IE-TDD-EL3313/Proyecto_3/docs/diseño/planteamiento.md

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

---

## 1. Introducción y comprensión del problema

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

---

## 2. Objetivos del proyecto

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

**Objetivos específicos:**

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

---

## 3. Arquitectura general y subsistemas

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

Los principales bloques funcionales considerados son:

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

**Distribución hardware / software:**

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

---

## 4. Diagrama de primer nivel

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

**Entradas:**

| Señal | Descripción |
|---|---|
| `CLK` | Reloj principal de 100 MHz. |
| `BTN_RST` | Solicitud de reinicio de la partida, procesada por software y conservando el contador de victorias. |
| `arriba`, `abajo`, `izquierda`, `derecha` | Navegación del cursor del Jugador 1. |
| `BTN_SEL` | Selección / rotación de barco. |
| `BTN_OK` | Confirmación de colocación o disparo. |
| `UART_RX` | Recepción serial desde la PC del Jugador 2. |

**Salidas:**

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

Diagrama de primer nivel del sistema

---

## 5. Diagrama de segundo nivel

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

Diagrama de segundo nivel del sistema

---

## 6. Diagramas de tercer nivel

El tercer nivel presenta los bloques funcionales internos de la solución, organizado en cuatro diagramas principales.

### 6.1 Procesador RISC-V

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

#### Señales de entrada

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

#### Señales de salida

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

#### Señales de control (generadas por la Unidad de Control)

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

#### Explicación del datapath

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

#### Memoria ROM

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

#### Bus de datos e interconexión MMIO

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

#### Decodificación de direcciones

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

Las principales señales de selección consideradas en la interconexión
son:

- `sel_RAM`
- `sel_UART`
- `sel_INPUT`
- `sel_DISPLAY`
- `sel_LED`
- `sel_BUZZER`
- `sel_VGA`

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

#### Generación de habilitaciones de escritura

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

\[
we_x = we_o \land sel_x
\]

donde `sel_x` representa la señal de selección del dispositivo
correspondiente.

Por ejemplo, para la memoria RAM y el periférico UART se tiene

\[
we_{RAM} = we_o \land sel_{RAM}
\]

\[
we_{UART} = we_o \land sel_{UART}
\]

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

#### Memoria RAM

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

\[
RAM\_addr =
\frac{DataAddress_o - BASE_{RAM}}{4}
\]

donde `BASE_RAM` corresponde a la dirección inicial de la región
reservada para la RAM.

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

#### Adaptación de direcciones de los periféricos

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

#### Multiplexor de lectura

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

De esta manera, durante una lectura se establece el siguiente recorrido
general:

`DataAddress_o` → decodificador → selección del dispositivo →
dato de lectura → multiplexor → `DataIn_i`.

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

#### Integración del periférico UART

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

### 6.4 Periféricos locales

El bloque de periféricos locales agrupa cuatro subsistemas: entradas del Jugador 1,
displays de 7 segmentos, LED de estado y buzzer. La decodificación de direcciones MMIO
se realiza externamente en el bloque de interconexión de P3. Por esta razón,
`perifericos_locales` no recibe una dirección local; cada periférico recibe directamente
su señal de escritura ya calificada y expone de forma independiente su dato de lectura
hacia el multiplexor central.

#### Señales de entrada

| Señal | Ancho | Origen | Descripción |
|---|---|---|---|
| `clk_i` | 1 bit | Externo | Reloj del sistema, 100 MHz. |
| `rst_i` | 1 bit | Externo | Reinicio de los periféricos locales. |
| `btn_raw_i[6:0]` | 7 bits | Botones físicos | Arriba, abajo, izquierda, derecha, SEL, OK y RST sin filtrar. |
| `disp_wdata_i[31:0]` | 32 bits | CPU / interconexión MMIO | Dato de escritura para el display de 7 segmentos. |
| `disp_we_i` | 1 bit | Decodificador MMIO | Habilitación de escritura del display. |
| `led_wdata_i[31:0]` | 32 bits | CPU / interconexión MMIO | Dato de escritura para el LED de estado. |
| `led_we_i` | 1 bit | Decodificador MMIO | Habilitación de escritura del LED. |
| `buzz_wdata_i[31:0]` | 32 bits | CPU / interconexión MMIO | Dato de escritura para el buzzer. |
| `buzz_we_i` | 1 bit | Decodificador MMIO | Habilitación de escritura del buzzer. |

#### Señales de salida

| Señal | Ancho | Destino | Descripción |
|---|---|---|---|
| `rdata_input_o[31:0]` | 32 bits | Multiplexor de lectura MMIO | Estado procesado de los botones del Jugador 1. |
| `rdata_display_o[31:0]` | 32 bits | Multiplexor de lectura MMIO | Valor almacenado en el registro del display. |
| `rdata_led_o[31:0]` | 32 bits | Multiplexor de lectura MMIO | Valor almacenado en el registro del LED. |
| `rdata_buzzer_o[31:0]` | 32 bits | Multiplexor de lectura MMIO | Estado y selección del buzzer. |
| `seg_o[6:0]` | 7 bits | Displays físicos | Patrón de segmentos activo en bajo. |
| `anode_o[3:0]` | 4 bits | Displays físicos | Selección de dígito activa en bajo. |
| `led_o[2:0]` | 3 bits | LED físicos | Indicador de fase del juego. |
| `buzz_pwm_o` | 1 bit | Buzzer físico | Señal de audio generada por el buzzer. |

#### Explicación del bloque
 
Las entradas físicas del Jugador 1 pasan por una cadena de sincronización, filtrado
antirrebote y detección de flanco antes de quedar disponibles en `rdata_input_o`. Los
displays de 7 segmentos almacenan cuatro dígitos BCD y los multiplexan por persistencia
de visión hacia `seg_o` y `anode_o`. El registro de LED controla directamente los tres
bits de `led_o`. El buzzer recibe un código de tono y un disparo puntual, y genera de
forma autónoma la señal de audio correspondiente.

Las direcciones MMIO (`0x0001_0120`, `0x0001_0130`, `0x0001_0138` y `0x0001_0140`)
son decodificadas fuera de este módulo. El bloque de interconexión de P3 genera las
señales `disp_we_i`, `led_we_i` y `buzz_we_i`, y selecciona posteriormente entre
`rdata_input_o`, `rdata_display_o`, `rdata_led_o` y `rdata_buzzer_o` para devolver
el dato correspondiente al CPU.

Diagrama de tercer nivel del sistema1

Diagrama de tercer nivel del sistema2

---

## 7. Diagramas de cuarto nivel

Cada módulo funcional identificado en el nivel anterior se documenta individualmente con:

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

**Formato de tabla de señales:**

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

**Módulos a documentar** (uno por cada uno, siguiendo el formato anterior):

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

### 7.1 Registros de transmisión y recepción del UART

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

#### Registro de transmisión (TX)

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

$$
load_{TX} = write\_enable_i \land (addr_i = 01)
$$

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

##### Entradas del registro TX

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

##### Salidas del registro TX

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

#### Registro de recepción (RX)

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

De forma conceptual, la operación de carga del registro puede
representarse como:

$$
RX \leftarrow rx\_data
\qquad \text{si} \qquad
rx\_load = 1
$$

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

##### Entradas del registro RX

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

##### Salidas del registro RX

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

Diagrama de cuarto nivel de los registros TX y RX del UART.

#### Relación con los demás módulos

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

Durante una transmisión, el flujo de información es:

**Procesador → `wdata_i` → Registro TX → UART TX → `uart_tx`**

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

Durante una recepción, el flujo ocurre en sentido contrario:

**`uart_rx` → UART RX → Registro RX → interfaz de lectura → Procesador**

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

#### Funcionamiento

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

#### Diseño y justificación técnica

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

#### Comportamiento durante el reset

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

$$
rst_i = 1
\quad \Rightarrow \quad
TX = 0,\qquad RX = 0
$$

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

#### Casos especiales y condiciones de borde

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

Estas condiciones pueden resumirse mediante:

$$
load_{TX}=0
\quad \Rightarrow \quad
TX_{next}=TX
$$

$$
rx\_load=0
\quad \Rightarrow \quad
RX_{next}=RX
$$

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

#### Estrategia de validación

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

### 7.2 Registro de control y estado del UART

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

#### Objetivo

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

La condición de selección del registro puede representarse como:

$$
sel_{CTRL} = (addr_i = 00)
$$

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

$$
write_{CTRL} =
write\_enable_i \land (addr_i = 00)
$$

#### Entradas

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

#### Salidas

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

Diagrama de cuarto nivel del registro de control y estado del UART.

#### Relación con los demás módulos

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

El flujo de información de estado puede representarse como:

**UART TX / UART RX → Registro de control y estado → MUX de lectura UART → Procesador**

Para las operaciones de control realizadas por software, el flujo ocurre
en sentido contrario:

**Procesador → `wdata_i` → Registro de control y estado → lógica interna del UART**

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

#### Funcionamiento

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

La selección del dato de estado durante una lectura se produce cuando:

$$
addr_i = 00
$$

Si existen campos de control modificables por software, estos solamente
pueden actualizarse cuando se cumple:

$$
write\_enable_i = 1
\qquad \text{y} \qquad
addr_i = 00
$$

por lo que:

$$
write_{CTRL} =
write\_enable_i \land (addr_i = 00)
$$

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

#### Diseño y justificación técnica

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

#### Comportamiento durante el reset

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

De forma conceptual:

$$
rst_i = 1
\quad \Rightarrow \quad
Control = Control_{inicial}
$$

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

#### Casos especiales y condiciones de borde

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

De forma equivalente:

$$
addr_i \neq 00
\quad \Rightarrow \quad
write_{CTRL}=0
$$

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

#### Estrategia de validación

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

### 7.3 Generador de baud

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

#### Objetivo

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

#### Entradas

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

#### Salidas

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

Diagrama de cuarto nivel del generador de baud.

#### Relación con los demás módulos

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

El flujo de la señal puede representarse como:

**`clk_i` → Generador de baud → `baud_tick` → UART TX / UART RX**

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

#### Funcionamiento

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

De forma conceptual, mientras no se alcance el valor terminal:

$$
contador_{next} = contador + 1
$$

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

El comportamiento puede representarse como:

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

y la actualización del contador como:

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

$$
N = \frac{f_{clk}}{f_{tick}}
$$

Para el sistema diseñado:

$$
f_{clk}=100\text{ MHz}
$$

mientras que la comunicación UART opera a:

$$
baud=115200\text{ baudios}
$$

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

#### Diseño y justificación técnica

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

#### Comportamiento durante el reset

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

Conceptualmente:

$$
rst_i=1
\quad\Rightarrow\quad
contador=0
$$

$$
rst_i=1
\quad\Rightarrow\quad
baud\_tick=0
$$

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

#### Casos especiales y condiciones de borde

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

#### Estrategia de validación

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

### 7.4 Transmisor UART

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

#### Objetivo

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

#### Entradas

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

#### Salidas

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

Diagrama de cuarto nivel del transmisor UART.

#### Relación con los demás módulos

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

El flujo principal de información puede representarse como:

**Registro TX → `tx_data` → UART TX → `uart_tx`**

Por otra parte, la temporización sigue el recorrido:

**Generador de baud → `baud_tick` → UART TX**

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

#### Funcionamiento

El transmisor se divide internamente en una sección de datos y una
sección de control.

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

#### Diseño y justificación técnica

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

#### Máquina de estados del transmisor

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

Las transiciones principales se representan conceptualmente como:

**IDLE → START**

cuando:

$$
tx\_start = 1
$$

Si no existe una solicitud de transmisión:

$$
tx\_start = 0
$$

la máquina permanece en `IDLE`.

Desde `START` se avanza a `DATA` cuando se presenta la referencia
temporal correspondiente:

$$
baud\_tick = 1
$$

Mientras no se haya alcanzado la última posición de datos, la máquina
permanece en `DATA`:

$$
baud\_tick = 1 \land \neg fin\_trama
$$

Cuando se alcanza la última posición:

$$
baud\_tick = 1 \land fin\_trama
$$

la máquina avanza hacia `STOP`.

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

Máquina de estados del transmisor UART.

#### Control interno del transmisor

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

La relación entre ambos bloques puede representarse como:

**FSM TX → `enable_cnt` → Contador**

y:

**Contador → `fin_trama` → FSM TX**

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

#### Comportamiento durante el reset

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

Conceptualmente:

$$
rst_i = 1
\quad\Rightarrow\quad
estado_{TX}=IDLE
$$

y:

$$
rst_i = 1
\quad\Rightarrow\quad
contador_{TX}=0
$$

Esto evita que una transmisión incompleta continúe después de un
reinicio del sistema.

#### Casos especiales y condiciones de borde

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

#### Estrategia de validación

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

Durante la simulación se comprobará que la máquina de estados siga la
secuencia esperada:

**IDLE → START → DATA → STOP → IDLE**

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

### 7.5 Receptor UART

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

#### Objetivo

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

#### Entradas

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

#### Salidas

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

Diagrama de cuarto nivel del receptor UART.

#### Relación con los demás módulos

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

El flujo principal de recepción puede representarse como:

**`uart_rx` → UART RX → `rx_data` → Registro RX**

El generador de baud proporciona la referencia temporal utilizada
durante este proceso:

**Generador de baud → `baud_tick` → UART RX**

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

El flujo de control correspondiente es:

**UART RX → `rx_done`, `rx_valid` → Lógica de detección/recuperación → `rx_load`**

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

#### Funcionamiento

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

#### Diseño y justificación técnica

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

#### Máquina de estados del receptor

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

$$
uart\_rx = 1
\quad\Rightarrow\quad
estado_{next}=IDLE
$$

Cuando se detecta la condición de inicio:

$$
uart\_rx = 0
\quad\Rightarrow\quad
IDLE \rightarrow START
$$

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

$$
baud\_tick = 1
\quad\Rightarrow\quad
START \rightarrow DATA
$$

Mientras no se haya alcanzado la última posición de datos, el receptor
permanece en `DATA`:

$$
baud\_tick = 1 \land \neg fin\_datos
\quad\Rightarrow\quad
DATA \rightarrow DATA
$$

Cuando se alcanza la última posición:

$$
baud\_tick = 1 \land fin\_datos
\quad\Rightarrow\quad
DATA \rightarrow STOP
$$

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

Máquina de estados del receptor UART.

#### Control interno del receptor

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

La relación entre ambos bloques puede representarse como:

**FSM RX → `enable_cnt` → Contador**

y:

**Contador → `fin_datos` → FSM RX**

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

#### Comportamiento durante el reset

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

Conceptualmente:

$$
rst_i = 1
\quad\Rightarrow\quad
estado_{RX}=IDLE
$$

$$
rst_i = 1
\quad\Rightarrow\quad
contador_{RX}=0
$$

Además, las indicaciones asociadas con una recepción completada deben
permanecer inactivas:

$$
rst_i = 1
\quad\Rightarrow\quad
rx\_done=0
$$

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

#### Casos especiales y condiciones de borde

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

Por lo tanto, la presencia de:

$$
rx\_done=1
$$

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

#### Estrategia de validación

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

**IDLE → START → DATA → STOP → IDLE**

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

### 7.6 Detección de dato recibido y descarte/recuperación

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

Esta separación evita que una recepción finalizada pero inválida
modifique el contenido disponible para el procesador.

#### Objetivo

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

Cuando la recepción finaliza correctamente, se genera `rx_load`, que
permite almacenar `rx_data` en el registro RX.

La condición utilizada es:

`rx_load = rx_done ∧ rx_valid`

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

`discard = rx_done ∧ ¬rx_valid`

De esta manera se distinguen claramente los casos de recepción válida e
inválida.

#### Entradas

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

#### Salidas

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

Diagrama de cuarto nivel de la detección de dato recibido y la lógica de descarte y recuperación.

#### Relación con los demás módulos

Este bloque se encuentra entre el receptor UART y el registro RX.

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

El flujo de datos es:

**UART RX → `rx_data` → Registro RX**

Mientras que el flujo de control es:

**UART RX → `rx_done`, `rx_valid` → Detección/recuperación → `rx_load` → Registro RX**

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

#### Funcionamiento

El funcionamiento del bloque depende de la combinación de `rx_done` y
`rx_valid`.

Cuando:

`rx_done = 0`

no existe una nueva recepción completada. Por lo tanto:

`rx_load = 0`

`discard = 0`

Si la recepción ha finalizado y el dato es válido:

`rx_done = 1`

`rx_valid = 1`

entonces:

`rx_load = 1`

`discard = 0`

En este caso, el registro RX puede almacenar el valor presente en
`rx_data`.

Por el contrario, si la recepción finaliza pero el resultado no es
válido:

`rx_done = 1`

`rx_valid = 0`

se obtiene:

`rx_load = 0`

`discard = 1`

En este caso el dato no debe cargarse en el registro RX.

La lógica puede resumirse mediante la siguiente tabla:

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

#### Detección de dato recibido

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

La expresión utilizada es:

`rx_load = rx_done ∧ rx_valid`

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

Cuando `rx_load = 1`, el registro RX realiza conceptualmente la
operación:

`RX_next = rx_data`

Si `rx_load = 0`, el contenido previamente almacenado se conserva:

`RX_next = RX`

Esto evita que una recepción incompleta o inválida sobrescriba un dato
recibido correctamente con anterioridad.

#### Descarte y recuperación

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

La expresión correspondiente es:

`discard = rx_done ∧ ¬rx_valid`

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

#### Diseño y justificación técnica

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

#### Comportamiento durante el reset

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

Conceptualmente:

`rx_done = 0  →  rx_load = 0`

y:

`rx_done = 0  →  discard = 0`

#### Casos especiales y condiciones de borde

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

Esto garantiza que solamente la combinación:

`rx_done = 1 ∧ rx_valid = 1`

produzca `rx_load = 1`.

Cuando una recepción sea inválida, el contenido anterior del registro RX
debe mantenerse sin cambios.

#### Estrategia de validación

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

Se verificará especialmente que para:

`rx_done = 1, rx_valid = 1`

se obtenga:

`rx_load = 1, discard = 0`

y que para:

`rx_done = 1, rx_valid = 0`

se obtenga:

`rx_load = 0, discard = 1`

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

**Diagrama modular:**

Diagrama de cuarto nivel — PLL

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

**Tabla de señales:**

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

**Ecuaciones:** `f_pix = f_clk / 4 = 25 MHz`.

**Comportamiento durante el reset:** con `rst_i` activo, `locked_o = 0` y `clk_pix_o` no se
considera válido.

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

---

### 7.8 Generador de temporización VGA

**Diagrama modular:**

Diagrama de cuarto nivel — Generador de temporización VGA

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

**Tabla de señales:**

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

**Ecuaciones / tablas:**
```
if (hcount==799): hcount<=0; h_max<=1   else: hcount<=hcount+1
if (h_max): if (vcount==524): vcount<=0  else: vcount<=vcount+1
hsync_o = NOT(hcount>=656 AND hcount<752)
vsync_o = NOT(vcount>=490 AND vcount<492)
video_on_o = (hcount<640) AND (vcount<480)
```

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

**Comportamiento durante el reset:** `hcount_o=0`, `vcount_o=0`, `video_on_o=1`,
`hsync_o=vsync_o=1`.

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

---

### 7.9 Memoria de video

**Diagrama modular:**

Diagrama de cuarto nivel — Memoria de video

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

**Tabla de señales:**

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

**Ecuaciones:**
```
tile_col = hcount_i[9:5]
tile_row = vcount_i[9:5]
tile_addr = tile_row*20 + tile_col

on posedge clk_i:
    if (vga_we_i AND vga_addr_i < 300):
        mem[vga_addr_i] <= vga_wdata_i

on posedge clk_pix_i:
    if (tile_addr < 300):
        tile_data_o <= mem[tile_addr]
    else:
        tile_data_o <= 0
```

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

**Casos especiales y condiciones de borde:** la memoria física contiene 300 palabras,
correspondientes a las 20×15 casillas visibles. Las escrituras con dirección mayor o igual
a 300 se ignoran y las lecturas fuera de este rango entregan cero. La lectura del puerto
de video es síncrona y presenta una latencia de un ciclo de `clk_pix_i`; por ello,
`vga_periferico` retrasa `video_on` un ciclo antes de entregarlo al generador de color,
manteniendo alineada la habilitación de video con `tile_data_o`. Una eventual colisión de
puertos sobre la misma dirección no es crítica para la visualización.

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

---

### 7.10 Generador de color y RGB

**Diagrama modular:**

Diagrama de cuarto nivel — Generador de color y RGB

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

**Tabla de señales:**

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

**Tabla de verdad (paleta a confirmar por el equipo):**

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

**Casos especiales y condiciones de borde:** `video_on_i=0` tiene prioridad absoluta sobre
cualquier color.

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

---

### 7.11 Condicionador de entradas de botones

**Diagrama modular:**

Diagrama de cuarto nivel — Condicionador de entradas de botones

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

**Tabla de señales:**

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

**Relación con los demás módulos:** módulo hoja; expone su registro al bus de periféricos.

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

**Codificación del registro `btn_status` (`0x0001_0120`):**

| Bit | Señal |
|---|---|
| `[0]` | `nav_up_pulse` |
| `[1]` | `nav_down_pulse` |
| `[2]` | `nav_left_pulse` |
| `[3]` | `nav_right_pulse` |
| `[4]` | `sel_pulse` |
| `[5]` | `ok_pulse` |
| `[6]` | `rst_pulse` |

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

---

### 7.12 Controlador de displays de 7 segmentos

**Diagrama modular:**

Diagrama de cuarto nivel — Controlador de displays de 7 segmentos

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

**Tabla de señales:**

| Señal | Ancho | Dirección | Descripción |
|---|---|---|---|
| `clk_i` | 1 bit | Entrada | Reloj del sistema, 100 MHz. |
| `rst_i` | 1 bit | Entrada | Reset del módulo. |
| `wdata_i` | 32 bits | Entrada | 4 dígitos BCD (`0x0001_0130`). |
| `we_i` | 1 bit | Entrada | Habilitación de escritura. |
| `seg_o` | 7 bits | Salida | Patrón de segmentos activo en bajo. |
| `anode_o` | 4 bits | Salida | Selección de dígito activa en bajo. |

**Relación con los demás módulos:** módulo hoja; recibe datos del CPU vía bus de periféricos.

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

**Tabla de verdad del decodificador (`seg_o[gfedcba]`, activo en bajo):**

La tarjeta Nexys 4 utiliza lógica activa en bajo tanto para los segmentos como para
la selección de los ánodos. Por tanto, un `0` lógico en `seg_o` enciende el segmento
correspondiente y un `0` lógico en `anode_o` habilita el dígito seleccionado.

| Dígito | `seg_o[gfedcba]` |
|---|---|
| 0 | `1000000` |
| 1 | `1111001` |
| 2 | `0100100` |
| 3 | `0110000` |
| 4 | `0011001` |
| 5 | `0010010` |
| 6 | `0000010` |
| 7 | `1111000` |
| 8 | `0000000` |
| 9 | `0010000` |

La selección de dígitos también es activa en bajo. Durante el multiplexado se
mantienen los ánodos no seleccionados en `1` y únicamente el ánodo correspondiente
al dígito activo se lleva a `0`.

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

---

### 7.13 Registro del LED de estado

**Diagrama modular:**

Diagrama de cuarto nivel — Registro del LED de estado

**Objetivo:** exponer hacia el LED físico el estado actual del sistema (colocación, batalla,
resultado).

**Tabla de señales:**

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

**Codificación propuesta:**

| `led_o` | Significado |
|---|---|
| `001` | Fase de colocación |
| `010` | Fase de batalla |
| `100` | Resultado final |

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

---

### 7.14 Generador del buzzer

**Diagrama modular:**

Diagrama de cuarto nivel — Generador del buzzer

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

**Tabla de señales:**

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

**Codificación propuesta del registro de control:**

| `tone_sel` | Evento |
|---|---|
| `000` | Impacto |
| `001` | Fallo |
| `010` | Barco hundido |
| `011` | Colocación inválida |
| `100` | Victoria |

**Comportamiento durante el reset:** contadores internos en 0, `buzz_pwm_o=0` (silencio).

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

---

### 7.15 Registro del PC

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

#### Objetivo

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

#### Entradas

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

#### Salidas

| Señal | Ancho | Dirección | Descripción |
|---|---:|---|---|
| `PC[31:0]` | 32 bits | Salida | Dirección de la instrucción actual. |

#### Relación con los demás módulos

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

El flujo de la señal puede representarse como:

**`NextPC` → Registro PC → `PC` → ROM / PC + 4 / Lógica de Branch**

#### Funcionamiento

En cada flanco de subida de `clk_i`, el registro captura `NextPC`:

$$
PC_{next} = NextPC
$$

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

#### Diseño y justificación técnica

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

#### Comportamiento durante el reset

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

$$
rst_i=1
\quad\Rightarrow\quad
PC=\texttt{0x0000\_0000}
$$

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

#### Casos especiales y condiciones de borde

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

#### Estrategia de validación

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

---

### 7.16 Sumador PC+4

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

#### Objetivo

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

#### Entradas

| Señal | Ancho | Dirección | Descripción |
|---|---:|---|---|
| `PC[31:0]` | 32 bits | Entrada | Dirección de la instrucción actual. |

#### Salidas

| Señal | Ancho | Dirección | Descripción |
|---|---:|---|---|
| `PCPlus4[31:0]` | 32 bits | Salida | Dirección de la instrucción secuencial siguiente. |

#### Relación con los demás módulos

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

**Registro PC → `PC` → Sumador PC+4 → `PCPlus4` → MUX Next PC / MUX Write-back**

#### Funcionamiento

El bloque suma la constante 4 al PC, ya que cada instrucción RV32I
ocupa 4 bytes:

$$
PCPlus4 = PC + 4
$$

#### Diseño y justificación técnica

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

#### Comportamiento durante el reset

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

#### Casos especiales y condiciones de borde

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

#### Estrategia de validación

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

---

### 7.17 Banco de registros

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

#### Objetivo

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

#### Entradas

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

#### Salidas

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

Diagrama de cuarto nivel del banco de registros.

#### Relación con los demás módulos

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

**Decodificador de instrucción → `rs1`/`rs2`/`rd` → Banco de registros → `RD1`/`RD2` → ALU / Branch / Memoria**

#### Funcionamiento

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

$$
RD1 =
\begin{cases}
0, & \text{si } rs1 = 0 \\
x[rs1], & \text{en otro caso}
\end{cases}
$$

$$
RD2 =
\begin{cases}
0, & \text{si } rs2 = 0 \\
x[rs2], & \text{en otro caso}
\end{cases}
$$

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

$$
WriteEnable[i] = RegWrite \cdot (rd = i), \quad i = 1,\dots,31
$$

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

#### Diseño y justificación técnica

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

#### Comportamiento durante el reset

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

#### Casos especiales y condiciones de borde

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

#### Estrategia de validación

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

---

### 7.18 ALU

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

#### Objetivo

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

#### Entradas

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

#### Salidas

| Señal | Ancho | Dirección | Descripción |
|---|---:|---|---|
| `ALU_Result[31:0]` | 32 bits | Salida | Resultado de la operación seleccionada. |

Diagrama de cuarto nivel de la ALU.

#### Relación con los demás módulos

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

**Multiplexores de operandos + Unidad de control → ALU → `ALU_Result` → Memoria de datos / MUX Write-back**

#### Funcionamiento

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

Las operaciones aritméticas se expresan como:

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

#### Diseño y justificación técnica

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

`ALU_Control` utiliza 4 bits porque solo hay diez operaciones distintas.

#### Comportamiento durante el reset

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

#### Casos especiales y condiciones de borde

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

#### Estrategia de validación

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

---

### 7.19 Generador de inmediatos

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

#### Objetivo

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

#### Entradas

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

#### Salidas

| Señal | Ancho | Dirección | Descripción |
|---|---:|---|---|
| `Imm[31:0]` | 32 bits | Salida | Inmediato extendido con signo. |

Diagrama de cuarto nivel del generador de inmediatos.

#### Relación con los demás módulos

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

**ROM → `ProgIn_i` → Generador de inmediatos → `Imm` → MUX B / Lógica de branch**

#### Funcionamiento

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

#### Diseño y justificación técnica

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

#### Comportamiento durante el reset

El bloque es combinacional y no requiere lógica de reset.

#### Casos especiales y condiciones de borde

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

#### Estrategia de validación

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

---

### 7.20 Unidad de control

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

#### Objetivo

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

#### Entradas

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

#### Salidas

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

Diagrama de cuarto nivel de la unidad de control.

#### Relación con los demás módulos

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

**Decodificador de instrucción → Unidad de control → señales de control → Datapath**

#### Funcionamiento

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

La señal `ALUSrcA` se mantiene en 0 (`RD1`) para todas las instrucciones
soportadas.

#### Diseño y justificación técnica

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

#### Comportamiento durante el reset

La unidad de control es combinacional y no requiere lógica de reset.

#### Casos especiales y condiciones de borde

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

#### Estrategia de validación

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

---

### 7.21 Comparador de bifurcaciones y lógica de branch/saltos

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

#### Objetivo

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

#### Entradas

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

#### Salidas

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

Diagrama de cuarto nivel del comparador de bifurcaciones.

Diagrama de cuarto nivel de la lógica de branch/saltos.

#### Relación con los demás módulos

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

**Banco de registros + Unidad de control → Comparador y lógica de branch → `TargetPC` / `PCsrc` → MUX Next PC**

#### Funcionamiento

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

| BranchCtrl | Instrucción | BranchTaken |
|---|---|---|
| `00` | `beq` | `EQ` |
| `01` | `bne` | `NE` |
| `10` | `blt` | `LT` |
| `11` | `bge` | `GE` |

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

Una red de compuertas AND aplica la máscara `0xFFFF_FFFE` para poner en
cero el bit 0:

$$
AlignedTarget = TargetSum \,\&\, \texttt{0xFFFFFFFE}
$$

Un segundo multiplexor, seleccionado por `JALR`, entrega `AlignedTarget`
para `jalr` y `TargetSum` en los demás casos.

**Selección de destino.** La señal `PCsrc` se obtiene con una
compuerta AND y una compuerta OR:

$$
ConditionalTaken = Branch \cdot BranchTaken
$$

$$
PCsrc = ConditionalTaken + Jump
$$

#### Diseño y justificación técnica

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

#### Comportamiento durante el reset

El bloque es combinacional y no requiere lógica de reset.

#### Casos especiales y condiciones de borde

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

#### Estrategia de validación

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

---

### 7.22 Multiplexores de operandos de la ALU

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

#### Objetivo

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

#### Entradas

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

#### Salidas

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

#### Relación con los demás módulos

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

**Banco de registros / Generador de inmediatos → MUX A / MUX B → ALU**

#### Funcionamiento

$$
ALU\_OperandA =
\begin{cases}
RD1, & \text{si } ALUSrcA = 0 \\
PC, & \text{si } ALUSrcA = 1
\end{cases}
$$

$$
ALU\_OperandB =
\begin{cases}
RD2, & \text{si } ALUSrcB = 0 \\
Imm, & \text{si } ALUSrcB = 1
\end{cases}
$$

#### Diseño y justificación técnica

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

#### Comportamiento durante el reset

Los multiplexores son combinacionales y no requieren lógica de reset.

#### Casos especiales y condiciones de borde

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

#### Estrategia de validación

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

---

### 7.23 Multiplexor de write-back

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

#### Objetivo

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

#### Entradas

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

#### Salidas

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

#### Relación con los demás módulos

`ResultSrc` proviene de la unidad de control. La salida `WriteData` se
conecta al banco de registros.

**ALU / Memoria / PC+4 → MUX Write-back → `WriteData` → Banco de registros**

#### Funcionamiento

$$
WriteData =
\begin{cases}
ALU\_Result, & ResultSrc = 00 \\
DataIn\_i, & ResultSrc = 01 \\
PCPlus4, & ResultSrc = 10
\end{cases}
$$

#### Diseño y justificación técnica

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

#### Comportamiento durante el reset

El multiplexor es combinacional y no requiere lógica de reset.

#### Casos especiales y condiciones de borde

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

#### Estrategia de validación

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

---

### 7.24 ROM

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

#### Objetivo

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

#### Entradas

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

#### Salidas

| Señal | Ancho | Dirección | Descripción |
|---|---:|---|---|
| `ProgIn_i[31:0]` | 32 bits | Salida | Instrucción almacenada en la dirección solicitada. |

#### Relación con los demás módulos

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

**Registro PC → `ProgAddress_o` → ROM → `ProgIn_i` → Decodificador de instrucción**

#### Funcionamiento

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

$$
ProgIn\_i = ROM[ProgAddress\_o[12:2]]
$$

El contenido se carga desde el archivo generado al ensamblar el
programa.

#### Diseño y justificación técnica

La lectura se describe como combinacional porque el procesador es de
ciclo único: la instrucción debe estar disponible dentro del mismo
ciclo en que el PC cambia. Con una lectura síncrona la instrucción
llegaría un ciclo tarde y el procesador ejecutaría la instrucción
anterior. El tamaño de 2048 palabras es pequeño y puede implementarse
con la memoria distribuida de la FPGA.

No se realiza un diagrama de cuarto nivel porque la ROM es un arreglo
de memoria sin lógica interna propia que descomponer.

#### Comportamiento durante el reset

El contenido de la ROM no depende de `rst_i`. Tras el reset, el PC vale
`0x0000_0000` y la ROM entrega la primera instrucción del programa.

#### Casos especiales y condiciones de borde

Las direcciones fuera del rango `0x0000_0000` a `0x0000_1FFF` no
ocurren en operación normal, y por eso no se les asigna comportamiento.
Los bits `[1:0]` de la dirección se ignoran.

#### Estrategia de validación

Se recorrerán las direcciones del programa cargado y se comparará
`ProgIn_i` contra el archivo fuente, incluyendo la primera y la última
palabra del rango.

---

### 7.25 RAM

La RAM almacena los datos del programa: los tableros de ambos jugadores,
el turno activo, los contadores de partidas y la pila. Se accede
mediante el bus de datos, compartido con los periféricos.

#### Objetivo

El objetivo de la RAM es almacenar y devolver palabras de 32 bits en
las direcciones del rango `0x0000_2000` a `0x0000_2FFF`.

#### Entradas

| Señal | Ancho | Dirección | Descripción |
|---|---:|---|---|
| `clk_i` | 1 bit | Entrada | Reloj principal del sistema. |
| `vam.addr[9:0]` | 10 bits | Entrada | Dirección local de palabra, generada por el adaptador de dirección. |
| `DataOut_o[31:0]` | 32 bits | Entrada | Dato a escribir, proveniente del procesador. |
| `we.RAM` | 1 bit | Entrada | Habilitación de escritura, proveniente del decodificador de direcciones. |

#### Salidas

| Señal | Ancho | Dirección | Descripción |
|---|---:|---|---|
| `vam.rdata[31:0]` | 32 bits | Salida | Dato leído de la dirección local. |

#### Relación con los demás módulos

El adaptador de dirección RAM convierte `DataAddress_o` en `vam.addr`,
el decodificador de direcciones genera `we.RAM` y la salida
`vam.rdata` se dirige al multiplexor de lectura. Se representa con el
mismo bloque que aparece en el diagrama de tercer nivel del sistema.

**Procesador → Adaptador de dirección → RAM → `vam.rdata` → MUX de lectura → `DataIn_i`**

#### Funcionamiento

La RAM contiene 1024 palabras de 32 bits (4 KiB). El adaptador de
dirección elimina la base `0x0000_2000` y los dos bits de byte,
quedando:

$$
vam.addr = DataAddress\_o[11:2]
$$

La escritura es síncrona: en el flanco de subida de `clk_i`, si
`we.RAM = 1`, se almacena `DataOut_o` en la posición `vam.addr`. La
lectura es combinacional:

$$
vam.rdata = RAM[vam.addr]
$$

#### Diseño y justificación técnica

Se utiliza lectura combinacional y escritura síncrona porque en un
procesador de ciclo único el dato de un `lw` debe estar disponible
dentro del mismo ciclo para escribirse en el banco de registros. El
adaptador de dirección permite que la RAM no dependa de su posición en
el mapa de memoria global.

No se realiza un diagrama de cuarto nivel porque la RAM es un arreglo
de memoria sin lógica interna propia que descomponer.

#### Comportamiento durante el reset

El contenido de la RAM no se reinicia con `rst_i`. El enunciado
establece que la limpieza de los tableros y de los contadores se
realiza por software en la etapa de inicialización del programa.

#### Casos especiales y condiciones de borde

Solo se escribe en la RAM cuando el decodificador de direcciones activa
`we.RAM`, es decir, cuando la dirección está dentro de su rango. Los
accesos en los extremos del rango (`0x0000_2000` y `0x0000_2FFC`) deben
funcionar correctamente.

#### Estrategia de validación

Se escribirán y leerán patrones de datos distintos en varias
direcciones, incluyendo la primera y la última palabra, y se
comprobará que una escritura con `we.RAM = 0` no modifica el contenido.

---

### 7.26 Decodificador de direcciones

El decodificador de direcciones determina, a partir de
`DataAddress_o`, qué memoria o periférico participa en el acceso de
datos actual. Incluye el generador de habilitaciones de escritura, que
combina cada selección con la señal `we_o` del procesador.

#### Objetivo

El objetivo del decodificador es activar una única línea de selección
por acceso y generar la habilitación de escritura correspondiente a la
RAM y a cada periférico.

#### Entradas

| Señal | Ancho | Dirección | Descripción |
|---|---:|---|---|
| `DataAddress_o[31:0]` | 32 bits | Entrada | Dirección del acceso a datos. |
| `we_o` | 1 bit | Entrada | Escritura solicitada por el procesador. |

#### Salidas

| Señal | Ancho | Dirección | Descripción |
|---|---:|---|---|
| `sel_RAM` | 1 bit | Salida | Selecciona la RAM de datos. |
| `sel_UART` | 1 bit | Salida | Selecciona el periférico UART. |
| `sel_INPUT` | 1 bit | Salida | Selecciona las entradas del Jugador 1. |
| `sel_DISPLAY` | 1 bit | Salida | Selecciona los displays de 7 segmentos. |
| `sel_LED` | 1 bit | Salida | Selecciona el LED de estado. |
| `sel_Buzzer` | 1 bit | Salida | Selecciona el buzzer. |
| `sel_VGA` | 1 bit | Salida | Selecciona la memoria de video. |
| `we.RAM`, `we.UART`, `we.DISPLAY`, `we.LED`, `we.Buzzer`, `we.VGA` | 1 bit c/u | Salida | Habilitación de escritura de cada destino. |

Diagrama de cuarto nivel del decodificador de direcciones.

#### Relación con los demás módulos

Recibe `DataAddress_o` y `we_o` del procesador. Las señales `sel_*`
controlan el multiplexor de lectura y las señales `we.*` se conectan a
la RAM y a cada periférico.

**Procesador → Decodificador de direcciones → `sel_*` / `we.*` → RAM / Periféricos / MUX de lectura**

#### Funcionamiento

Cada selección se obtiene comparando la dirección con el rango del
mapa de memoria definido en el enunciado:

| Señal | Rango de direcciones |
|---|---|
| `sel_RAM` | `0x0000_2000` a `0x0000_2FFF` |
| `sel_UART` | `0x0001_0040` a `0x0001_0048` |
| `sel_INPUT` | `0x0001_0120` |
| `sel_DISPLAY` | `0x0001_0130` |
| `sel_LED` | `0x0001_0138` |
| `sel_Buzzer` | `0x0001_0140` |
| `sel_VGA` | `0x0001_1000` a `0x0001_17FF` |

Cada habilitación de escritura se obtiene como:

$$
we.X = we\_o \cdot sel\_X
$$

Las entradas del Jugador 1 son de solo lectura, por lo que no tienen
señal de escritura.

#### Diseño y justificación técnica

Se decodifica por rangos para cubrir de forma simple los destinos que
ocupan varias direcciones: los tres registros del UART y la memoria de
video, que abarca 512 palabras. Los rangos son disjuntos, así que a lo
sumo una selección está activa por acceso.

#### Comportamiento durante el reset

El decodificador es combinacional y no requiere lógica de reset.

#### Casos especiales y condiciones de borde

Una dirección fuera de todos los rangos no activa ninguna selección ni
ninguna habilitación de escritura, de modo que una escritura a una
dirección inválida no afecta ningún destino. Las direcciones del UART
dentro del rango pero no asignadas a un registro deben tratarse según
la definición del periférico.

#### Estrategia de validación

Se recorrerán direcciones dentro y fuera de cada rango, incluyendo el
primer y el último valor de cada uno, verificando que como máximo una
línea `sel_*` esté activa y que cada `we.*` solo se active cuando
`we_o = 1` y la dirección corresponda a su destino.

---

### 7.27 Multiplexor de lectura

El multiplexor de lectura selecciona cuál de las fuentes de datos
(RAM o periféricos) responde a una lectura del procesador.

#### Objetivo

El objetivo del multiplexor es entregar `DataIn_i` con el dato de la
memoria o del periférico seleccionado por el decodificador de
direcciones.

#### Entradas

| Señal | Ancho | Dirección | Descripción |
|---|---:|---|---|
| `vam.rdata[31:0]` | 32 bits | Entrada | Dato leído de la RAM. |
| `rdata_UART[31:0]` | 32 bits | Entrada | Dato leído del UART. |
| `rdata_INPUT[31:0]` | 32 bits | Entrada | Dato leído de las entradas del Jugador 1. |
| `rdata_DISPLAY[31:0]` | 32 bits | Entrada | Dato leído de los displays. |
| `rdata_LED[31:0]` | 32 bits | Entrada | Dato leído del LED de estado. |
| `rdata_Buzzer[31:0]` | 32 bits | Entrada | Dato leído del buzzer. |
| `rdata_VGA[31:0]` | 32 bits | Entrada | Dato leído de la memoria de video. |
| `sel_*` | 1 bit c/u | Entrada | Señales de selección del decodificador de direcciones. |

#### Salidas

| Señal | Ancho | Dirección | Descripción |
|---|---:|---|---|
| `DataIn_i[31:0]` | 32 bits | Salida | Dato entregado al procesador. |

#### Relación con los demás módulos

Recibe las salidas de lectura de la RAM y de los periféricos, y las
selecciones del decodificador de direcciones. Su salida se conecta al
puerto `DataIn_i` del procesador.

**RAM / Periféricos → MUX de lectura → `DataIn_i` → Procesador**

#### Funcionamiento

La salida corresponde a la fuente cuya señal de selección está activa:

$$
DataIn\_i =
\begin{cases}
vam.rdata, & sel\_RAM = 1 \\
rdata\_UART, & sel\_UART = 1 \\
\vdots & \vdots \\
rdata\_VGA, & sel\_VGA = 1 \\
0, & \text{en otro caso}
\end{cases}
$$

#### Diseño y justificación técnica

Se utiliza un multiplexor central en lugar de un bus compartido con
lógica de tres estados, porque los buses tri-estado internos no son la
práctica recomendada en una FPGA y el multiplexor es más sencillo de
sintetizar y verificar. Como el decodificador activa a lo sumo una
selección, no hay ambigüedad.

#### Comportamiento durante el reset

El multiplexor es combinacional y no requiere lógica de reset.

#### Casos especiales y condiciones de borde

Si ninguna selección está activa, la salida se fuerza a cero. Esto evita
inferir latches y entrega un valor definido ante una lectura de
dirección inválida.

#### Estrategia de validación

Se validará junto con el decodificador de direcciones: para cada
dirección de prueba se comprobará que `DataIn_i` corresponda a la
fuente esperada y que valga cero para direcciones fuera de rango.

## 8. Mapa de memoria, registros y organización de datos

### 8.1 Mapa de memoria

| Rango de direcciones | Componente |
|---|---|
| `0x0000_0000 – 0x0000_1FFF` | ROM de programa |
| `0x0000_2000 – 0x0000_2FFF` | RAM de datos |
| `0x0001_0000 – 0x0001_FFFF` | Periféricos mapeados en memoria |
| `0x0001_1000 – 0x0001_17FF` | Memoria de video VGA |

### 8.2 Registros de periféricos

| Periférico | Registro | Dirección |
|---|---|---|
| UART | Control/Estado | `0x0001_0040` |
| UART | Datos TX | `0x0001_0044` |
| UART | Datos RX | `0x0001_0048` |
| Entradas J1 | Estado | `0x0001_0120` |
| Displays 7-seg | Datos | `0x0001_0130` |
| LED de estado | Datos | `0x0001_0138` |
| Buzzer | Control | `0x0001_0140` |

### 8.3 Organización lógica de la RAM

La memoria RAM del sistema se encuentra ubicada en el intervalo de
direcciones comprendido entre `0x0000_2000` y `0x0000_2FFF`. Esta memoria
es utilizada por el procesador para almacenar información modificable
durante la ejecución del programa.

A diferencia de la ROM, cuyo contenido corresponde al programa ejecutado
por el procesador, la RAM almacena los datos necesarios para mantener el
estado actual de la aplicación.

#### Organización propuesta

Para facilitar el acceso desde el programa en ensamblador, se propone
dividir lógicamente la RAM en diferentes regiones de acuerdo con la
función de los datos almacenados.

La organización general propuesta es:

| Región | Contenido |
|---|---|
| Tablero local | Estado de las posiciones correspondientes al tablero del jugador local. |
| Tablero remoto | Información conocida sobre el tablero del jugador remoto. |
| Información de barcos | Datos necesarios para representar la posición y estado de los barcos. |
| Estado de la partida | Variables utilizadas para representar la etapa actual del juego. |
| Control de turnos | Información utilizada para determinar el jugador que posee el turno. |
| Resultados de disparos | Información temporal asociada con las acciones realizadas durante la partida. |
| Variables auxiliares | Contadores, índices y datos temporales utilizados por el programa. |

Esta separación es lógica y permite que el software mantenga organizada
la información utilizada durante la ejecución.

#### Direccionamiento

El procesador accede a la RAM mediante `DataAddress_o[31:0]`. Debido a
que la RAM comienza en la dirección `0x0000_2000`, la dirección interna
puede obtenerse conceptualmente eliminando el desplazamiento
correspondiente a la dirección base.

Para accesos organizados por palabras de 32 bits, la adaptación puede
representarse como:

`ram_addr = (DataAddress_o - 0x0000_2000) / 4`

De esta manera:

`0x0000_2000 → palabra 0`

`0x0000_2004 → palabra 1`

`0x0000_2008 → palabra 2`

y así sucesivamente dentro del espacio asignado a la RAM.

#### Acceso desde el procesador

Cuando `DataAddress_o` se encuentra dentro del intervalo asignado a la
RAM, el decodificador de direcciones activa `sel_RAM`.

La selección puede representarse conceptualmente como:

`sel_RAM = 1`, si `0x0000_2000 ≤ DataAddress_o ≤ 0x0000_2FFF`

Para una operación de escritura, la habilitación de la memoria se
obtiene mediante:

`we_RAM = we_o ∧ sel_RAM`

Cuando `we_RAM = 1`, el valor presente en `DataOut_o[31:0]` puede ser
almacenado en la posición seleccionada de la RAM.

Durante una lectura, el dato obtenido de la memoria se entrega mediante
`ram_rdata[31:0]` al multiplexor general de lectura:

**RAM → `ram_rdata` → MUX de lectura → `DataIn_i` → CPU**

#### Uso durante la ejecución del juego

Al comenzar la ejecución del programa, las estructuras necesarias para
representar el estado de la partida deben inicializarse antes de iniciar
el intercambio de información entre los jugadores.

Durante la fase de colocación, la RAM permite almacenar la información
que representa la configuración utilizada por el juego. Posteriormente,
durante el desarrollo de la partida, el procesador puede actualizar las
posiciones afectadas por las acciones realizadas y conservar la
información necesaria para controlar los turnos y el progreso del juego.

La utilización de regiones lógicas independientes facilita que las
rutinas en ensamblador accedan a cada estructura mediante direcciones
base y desplazamientos conocidos.

#### Justificación de la organización

La división lógica de la memoria permite separar la información según su
función y simplifica el desarrollo del programa en ensamblador.

Además, utilizar posiciones conocidas dentro de la RAM permite acceder a
las diferentes estructuras mediante operaciones convencionales de carga
y almacenamiento del procesador, sin requerir hardware adicional para
distinguir cada variable del juego.

Esta organización también facilita la depuración, ya que durante las
pruebas es posible inspeccionar regiones específicas de la memoria y
comprobar de forma independiente el contenido asociado con cada parte
del estado de la partida.

#### Condiciones de borde

Los accesos destinados a la RAM deben permanecer dentro del intervalo:

`0x0000_2000 – 0x0000_2FFF`

Una dirección fuera de este intervalo no debe activar `sel_RAM`.

Asimismo, al utilizar accesos por palabras de 32 bits, las estructuras
de software deben respetar la organización y alineamiento definidos para
evitar que dos variables utilicen accidentalmente la misma posición de
memoria.

#### Estrategia de validación

La organización de la RAM se verificará inicialmente mediante
simulación, realizando operaciones de escritura y lectura sobre
diferentes posiciones dentro del intervalo asignado.

Se comprobará que una escritura con `we_RAM = 1` modifique únicamente la
posición seleccionada y que una lectura posterior permita recuperar el
mismo valor mediante `ram_rdata`.

También se probarán las direcciones inicial y final del espacio asignado
a la RAM, así como direcciones externas al intervalo, verificando que el
decodificador active `sel_RAM` únicamente cuando corresponda.

Durante la integración con el programa en ensamblador se comprobará que
las diferentes estructuras lógicas puedan actualizarse sin interferir
entre sí.

### 8.4 Interfaz de periféricos

Los periféricos se integran al espacio MMIO mediante el decodificador de direcciones
central. Este bloque identifica la dirección solicitada por el CPU y genera una señal
de selección o escritura específica para el periférico correspondiente. De esta forma,
los periféricos que ocupan una única palabra no requieren recibir ni decodificar
localmente la dirección completa.

Las transferencias de datos se realizan mediante palabras de 32 bits. Cada periférico
expone su dato de lectura hacia el multiplexor central, que selecciona la respuesta
correspondiente según la dirección solicitada por el CPU. El VGA constituye un caso
particular, ya que su memoria de video ocupa un rango de direcciones y utiliza un índice
de 9 bits para seleccionar las posiciones de su ventana MMIO.

---

## 9. Protocolo UART, flujo del programa y aplicación de PC
### 9.1 Protocolo de aplicación sobre UART

La comunicación entre la FPGA y la aplicación ejecutada en la
computadora del Jugador 2 se realiza mediante el periférico UART a una
velocidad de 115200 baudios. En este proyecto, UART constituye el único
medio de interacción del Jugador 2 con la partida.

El protocolo de aplicación permite transmitir las órdenes del Jugador 2
hacia la FPGA y enviar desde la FPGA la información necesaria para que
la aplicación mantenga actualizada la representación de la partida.

#### Formato general de las tramas

Se propone utilizar un protocolo basado en caracteres ASCII. Cada
mensaje está compuesto por un identificador seguido por los campos
necesarios para representar la información correspondiente.

Los campos se separan mediante comas y cada trama termina con el
carácter de salto de línea `\n`.

El formato general es:

`TIPO,CAMPO1,CAMPO2,...\n`

Esta estructura permite identificar fácilmente el comienzo lógico del
mensaje mediante su tipo y detectar su final mediante `\n`.

La utilización de caracteres ASCII facilita tanto la implementación de
la aplicación Python como la depuración de la comunicación mediante una
terminal serial.

#### Mensajes desde la PC hacia la FPGA

La aplicación del Jugador 2 debe poder enviar como mínimo dos tipos de
órdenes: colocación de barcos y disparos.

##### Colocación de barco

Se define el mensaje:

`P,barco,fila,columna,orientacion\n`

donde:

| Campo | Descripción |
|---|---|
| `P` | Identifica una solicitud de colocación de barco. |
| `barco` | Identificador del barco, con valores entre 0 y 2. |
| `fila` | Fila de la casilla inicial. |
| `columna` | Columna de la casilla inicial. |
| `orientacion` | Orientación del barco: `H` para horizontal o `V` para vertical. |

Por ejemplo:

`P,1,3,4,H\n`

indica una solicitud para colocar el barco identificado como `1`,
iniciando en la fila `3`, columna `4`, con orientación horizontal.

La FPGA debe comprobar que la colocación sea válida antes de modificar
el estado de la partida.

##### Disparo

Para solicitar un disparo se define el mensaje:

`S,fila,columna\n`

donde:

| Campo | Descripción |
|---|---|
| `S` | Identifica una solicitud de disparo. |
| `fila` | Fila de la casilla objetivo. |
| `columna` | Columna de la casilla objetivo. |

Por ejemplo:

`S,5,2\n`

representa un disparo del Jugador 2 dirigido a la casilla ubicada en la
fila `5` y columna `2` del tablero del Jugador 1.

#### Mensajes desde la FPGA hacia la PC

La FPGA debe informar a la aplicación del Jugador 2 sobre los eventos
que modifican o afectan el estado de la partida.

Se proponen los siguientes tipos de mensajes.

##### Resultado de colocación

Cuando la FPGA procesa una solicitud de colocación, responde indicando
si fue aceptada o rechazada.

Colocación aceptada:

`PA,barco\n`

Por ejemplo:

`PA,1\n`

indica que la colocación del barco `1` fue aceptada.

Si la colocación es rechazada:

`PR,barco,motivo\n`

Los motivos requeridos para el rechazo son:

| Código | Motivo |
|---|---|
| `O` | El barco se traslapa con otro barco previamente colocado. |
| `F` | La posición solicitada provoca que el barco quede fuera del tablero. |

Por ejemplo:

`PR,1,O\n`

indica que la colocación del barco `1` fue rechazada debido a un
traslape.

#### Inicio de la fase de batalla

Cuando ambos jugadores hayan completado la colocación de su flota, la
FPGA informa a la aplicación que inicia la fase de batalla.

Se utiliza:

`B\n`

donde `B` representa el inicio de la batalla.

#### Cambio de turno

Para informar a quién corresponde realizar la siguiente acción se
utiliza:

`T,jugador\n`

donde `jugador` identifica al jugador que posee el turno.

Por ejemplo:

`T,2\n`

indica que corresponde actuar al Jugador 2.

#### Resultado de un disparo del Jugador 2

Después de procesar un disparo enviado por la PC, la FPGA devuelve su
resultado mediante:

`SR,fila,columna,resultado\n`

Se proponen los siguientes códigos para `resultado`:

| Código | Resultado |
|---|---|
| `F` | Fallo. |
| `I` | Impacto. |
| `H` | Barco hundido. |

Por ejemplo:

`SR,5,2,I\n`

indica que el disparo realizado sobre la fila `5`, columna `2`, produjo
un impacto.

#### Disparo recibido del Jugador 1

Cuando el Jugador 1 realiza un disparo sobre el tablero del Jugador 2,
la FPGA debe informar a la aplicación para que esta pueda actualizar la
representación del tablero propio.

Se utiliza:

`DR,fila,columna,resultado\n`

donde `resultado` utiliza los mismos códigos definidos anteriormente.

Por ejemplo:

`DR,3,6,F\n`

indica que el Jugador 1 realizó un disparo sobre la fila `3`, columna
`6`, del tablero del Jugador 2 y el resultado fue un fallo.

#### Resultado final de la partida

Cuando la partida termina, la FPGA envía:

`FIN,ganador\n`

donde `ganador` identifica al jugador que obtuvo la victoria.

Por ejemplo:

`FIN,2\n`

indica que el Jugador 2 ganó la partida.

El mensaje final puede ampliarse posteriormente con los campos
necesarios para incluir el resumen de la partida requerido por el
sistema.

#### Resumen de mensajes

| Dirección | Trama | Función |
|---|---|---|
| PC → FPGA | `P,barco,fila,columna,orientacion\n` | Solicitud de colocación de un barco. |
| PC → FPGA | `S,fila,columna\n` | Solicitud de disparo. |
| FPGA → PC | `PA,barco\n` | Colocación aceptada. |
| FPGA → PC | `PR,barco,motivo\n` | Colocación rechazada. |
| FPGA → PC | `B\n` | Inicio de la fase de batalla. |
| FPGA → PC | `T,jugador\n` | Cambio de turno. |
| FPGA → PC | `SR,fila,columna,resultado\n` | Resultado de un disparo del Jugador 2. |
| FPGA → PC | `DR,fila,columna,resultado\n` | Disparo recibido desde el Jugador 1. |
| FPGA → PC | `FIN,ganador\n` | Resultado final de la partida. |

#### Validación de mensajes

La aplicación Python debe validar la información introducida por el
Jugador 2 antes de transmitirla. Esto permite evitar el envío de
comandos evidentemente incorrectos.

Sin embargo, la FPGA también debe validar todos los mensajes recibidos y
no puede depender únicamente de la validación realizada por la
aplicación.

Un mensaje recibido debe comprobarse antes de modificar el estado de la
partida. Entre las condiciones que deben verificarse se encuentran:

- que el tipo de mensaje sea reconocido;
- que exista la cantidad esperada de campos;
- que los campos posean valores válidos;
- que el identificador del barco se encuentre entre 0 y 2;
- que la fila y columna correspondan a posiciones válidas del tablero;
- que la orientación sea `H` o `V`;
- que la acción corresponda con la fase actual de la partida;
- que el jugador pueda realizar la acción en el turno correspondiente.

#### Manejo de datos inválidos

Cualquier mensaje que no cumpla con el formato establecido debe ser
descartado sin modificar el estado actual de la partida.

Conceptualmente:

`mensaje válido → procesar comando`

`mensaje inválido → descartar y conservar estado`

De esta forma, un dato incorrecto recibido mediante UART no debe
provocar la colocación de un barco, modificar un tablero, cambiar un
turno ni generar un disparo.

Después de descartar un mensaje inválido, el sistema debe continuar
esperando una nueva trama, permitiendo recuperar la comunicación sin
necesidad de reiniciar la partida.

#### Ejemplo de comunicación

Un posible intercambio durante la colocación del Jugador 2 es:

PC → FPGA:

`P,0,2,3,H\n`

FPGA → PC:

`PA,0\n`

Posteriormente, si se intenta colocar otro barco en una posición que
produce traslape:

PC → FPGA:

`P,1,2,4,V\n`

la FPGA puede responder:

`PR,1,O\n`

Durante la fase de batalla, la FPGA informa el turno:

FPGA → PC:

`T,2\n`

El Jugador 2 realiza entonces un disparo:

PC → FPGA:

`S,5,2\n`

y la FPGA devuelve, por ejemplo:

`SR,5,2,I\n`

indicando que el disparo produjo un impacto.

Este intercambio permite que la aplicación de PC mantenga actualizada
la información presentada al Jugador 2 mientras la FPGA conserva el
control del estado general de la partida.

### 9.2 Flujo del programa ensamblador
Inicialización → colocación concurrente (J1 por VGA/botones, J2 por UART) → fase de batalla (turnos, disparos, actualización) → fin de partida → reinicio (`BTN_RST`) conservando el contador de partidas ganadas.

*(Redactar: propuesta de subrutinas y convención de registros)*

### 9.3 Aplicación de PC en Python
*(Redactar: arquitectura de la aplicación, uso de pyserial, visualización de tablero propio y estado conocido del rival, validación de entradas del usuario)*

---

## 10. Decisiones de diseño y justificación

- **Arquitectura del núcleo:** *(justificar ciclo único vs. multiciclo, tipo de unidad de control)*
- **Organización de memoria:** *(justificar bus dedicado de ROM vs. bus compartido de RAM/periféricos)*
- **Diseño VGA:** se eligió una cuadrícula de 20×15 bloques de 32×32 píxeles porque 32 es
  potencia de 2, lo que permite calcular fila/columna de tile tomando directamente los bits
  superiores de `hcount`/`vcount` (desplazamiento) en vez de un divisor aritmético completo, y
  porque esa cuadrícula alcanza para representar ambos tableros 8×8 más el HUD. La
  sincronización entre el dominio de 100 MHz (escritura del CPU) y el de 25 MHz (lectura de
  video) se resuelve mediante una memoria de tiles de doble puerto y doble reloj, primitiva
  nativa de la FPGA, sin necesidad de lógica de sincronización adicional diseñada por el
  equipo.
- **Diseño UART:** *(justificar reutilización del Proyecto 2 y ajustes necesarios)*
- **Organización de tableros:** *(justificar estructura de datos elegida)*
- **Protocolo de comunicación:** *(justificar formato de trama elegido)*

---

## 11. Estrategia de validación y plan de implementación

### 11.1 Validación por bloque

| Bloque | Prueba | Resultado esperado |
|---|---|---|
| Núcleo RISC-V | Testbench autoverificable por instrucción | Registros/memoria coinciden con el valor esperado |
| ROM / RAM | Lectura/escritura en direcciones de borde | Sin corrupción de datos |
| UART | Loopback TX→RX | Trama recibida coincide con la transmitida a 115200 baudios |
| Entradas J1 | Rebotes simulados | Antirrebote entrega un único flanco limpio |
| VGA | Inspección de temporización | `VGA_HS`/`VGA_VS` cumplen 640×480@60Hz |

### 11.2 Plan de implementación
*(Redactar: orden progresivo, p. ej. generadores de habilitación → memorias → UART → núcleo con testbench propio → VGA → entradas → integración → ensamblador del juego → aplicación Python → simulación integral → pruebas en placa)*

### 11.3 Riesgos y mitigaciones

| Riesgo | Mitigación |
|---|---|
| | |

---

## 12. Distribución del trabajo

| Persona | Área principal |
|---|---|
| P1 | Procesador RISC-V: datapath, unidad de control, banco de registros, ALU, interfaz del procesador |
| P2 | VGA y periféricos locales: controlador VGA, memoria de tiles, sistema de relojes, botones, displays, LED, buzzer |
| P3 | Memorias, interconexión y comunicación: ROM, RAM, decodificación MMIO, UART, organización de datos, protocolo, software |
| Todos | Integración: interfaces, nombres de señales, anchos de buses, comportamiento del reset, revisión cruzada |

*(Completar tabla de revisión cruzada y cronograma si se desea documentar aquí)*

---

## 13. Referencias

*(Listar fuentes utilizadas para RISC-V, VGA, UART, debouncing, Python y demás decisiones técnicas)*

## Referencias

1. L. Llamas, *"Controlador VGA con FPGA"*, [En línea]. Disponible en: https://www.luisllamas.es/fpga-vga-hdmi-generacion-video/ [Accedido: 2026-09-24].
2. Y. Alkattan, *"640x480 VGA framebuffer en FPGA"*, Repositorio de GitHub. Disponible en: https://github.com/Yousef-Alkattan/640x480-VGAframebuffer
3. Enciclopedia Académica, *"Señal de sincronismo VGA"*, [En línea]. Disponible en: https://es-academic.com/dic.nsf/eswiki/495866
