IE-TDD-EL3313/Proyecto_3/(commit log)

2026-09-24 Se crean las carpetas para el diseño y el informe final
2026-09-24 Se agrega plantilla para el documento del diseño
    Plantilla para documento del diseño del proyecto de Battle ship
2026-09-24 se agregan carpetas para figuras
2026-09-24 Pequeños ajustes de la plantilla
2026-09-25 se agrega informacion sobre el diagrama tercer nivel del procesador
    Updated the design document for the Batalla Naval project, including objectives, architecture, diagrams, and validation strategies.
2026-09-25 se agrega la imagen del diagrama de segundo nivel al documento
    This commit updates the design document for the 'Batalla Naval' project, detailing the introduction, objectives, architecture, diagrams, memory map, UART protocol, and design decisions.
2026-09-25 correcion de error en el codigo de images
    This commit updates the design document for the 'Batalla Naval' project, detailing the architecture, objectives, and system components. It includes diagrams and descriptions of the RISC-V microprocessor, memory organization, and peripheral interfaces.
2026-09-25 imagenes de diagrama de tercer nivel
2026-09-25 se agregan las imagenes del diagrama de tercer nivel del sistema
    Updated design document for the Batalla Naval project, detailing architecture, objectives, and system diagrams.
2026-09-25 Seccion 6.2 explicacion de manejo de memorias,
2026-09-25 Se agrega diagrama de primer nivel
2026-09-25 Diagrama control de estado
2026-09-25 Seccion 7.2, explicacion registro de control
2026-09-25 Update print statement from 'Hello' to 'Goodbye'
2026-09-25 Seccion 7.3 generador de baud
2026-09-25 Generador de baud
2026-09-25 uart tx
2026-09-25 Seccion 7.4 explicacion del uart tx
2026-09-25 Seccion 7.5 explicacion del uart tx
2026-09-25 uart rx
2026-09-25 Seccion 7.6, explicacion deteccion de dato recinbido
2026-09-25 Explicacion de organizacion RAM
2026-09-25 Update seccion 10
    Se agrega justificacion del diseño de la VGA, faltan las demás segun a quien le correspondan
2026-09-26 Correccion menor
    Se cambia la extensión de los diagramas de cuarto nivel de las secciones 7.7 - 7.14 de .jpeg a .png
2026-09-26 Se suben archivos de imagen
    Se suben las imágenes correspondientes a los diagramas de cuarto nivel de las secciones 7.7 - 7.14
2026-09-26 Se movieron imagenes hacia la carpeta fig
2026-09-28 Se agrega documentacion de los diagrams de cuarto nivel del procesador
2026-09-28 se agrega imagen del decodificador de direcciones
2026-09-30 Se agrega una carpeta con los modulos de persona 2, aún estan pendientes los tb
2026-10-04 docs: reorganizar documentación de diseño
2026-10-04 refactor: reorganizar módulos RTL y testbench de P2
2026-10-04 fix: corregir memoria y reloj de pixel VGA
    [vga_memory.sv, vga_periferico.sv]
2026-10-04 feat: agregar constraints VGA para Nexys 4
2026-10-04 test: agregar pruebas para memoria VGA
2026-10-04 test: validar generacion de color VGA
2026-10-04 test: corregir compatibilidad de testbench de botones
2026-10-04 fix: corregir polaridad y validar display de 7 segmentos
    [seg7_ctrl.sv, seg7_ctrl_tb.sv]
2026-10-04 test: validar registro de LED de estado
2026-10-04 test: validar generador de buzzer
    [buzzer_gen_tb.sv]
2026-10-04 test: validar integracion de perifericos locales
2026-10-04 fix: optimizar divisor de frecuencia del buzzer
    [buzzer_gen.sv]
2026-10-04 docs: corregir polaridad del display de 7 segmentos
2026-10-04 docs: actualizar comportamiento de memoria VGA
2026-10-04 docs: actualizar interfaz de perifericos locales
2026-10-04 docs: aclarar funcion del boton de reinicio
2026-10-04 docs: actualizar interfaz MMIO de perifericos
2026-10-05 Se agregan al nexys4.xdc los pines de botones del Jugador 1, display de 7 segmentos (segmentos y ánodos AN0-AN3), LED de estado (LED0-LED2), buzzer (PMOD JA1) y botón CPU RESET. SEL y RST del juego s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
    [nexys4.xdc]
2026-10-05 archivos de testbench del cpu
2026-10-05 se agregan archivos de firmware del cpu
2026-10-05 se agregan los resultas en la carpeta sim del cpu
2026-10-05 feat: implementar periferico UART con interfaz MMIO
2026-10-05 test: completar pruebas de batalla UART y disparos
2026-10-08 Add Plantilla para el informe
2026-10-08 fix: integrar CPU, VGA, buzzer y marcador con pruebas en FPGA
    [address_decoder.sv, btn_input.sv, btn_input_tb.sv, buzzer_gen.sv, buzzer_gen_tb.sv, buzzer_hw_test.sv, game_firmware_tb.sv, nexys4.xdc]
2026-10-08 feat(pc): implementar interfaz interactiva para colocacion y disparos
2026-10-08 feat(vga): integrar renderizado de texto HUD y pruebas
2026-10-08 fix(fpga): adaptar displays de 7 segmentos a Nexys 4
    [nexys4.xdc, perifericos_locales.sv, seg7_ctrl.sv, sistema_top.sv]
2026-10-08 docs(informe): corregir afirmaciones sobre UART y modelo de PLL en seccion 8
2026-10-08 docs(informe): secciones 9 y 10 (ensamblador y aplicacion de PC)
2026-10-08 docs(informe): secciones 11 a 14, resumen y referencias; limpieza de plantilla
2026-10-08 Correcciones menores
    Se corrigieron errores de redacción
2026-10-09 Modificaci´n de la sección del procesador
2026-10-09 se agrega diagrama para el informe
2026-10-09 feat: sincronizar estadisticas UART entre FPGA y Python
2026-10-09 docs: actualizar informe con validacion y resultados finales de P3
